lucaricciatl/hand-virtualization/Relazione SGN - VR hand/copertina.tex

%Copertina

\title{Progetto del corso di Sistemi di Guida e Navigazione}
\author{
  Ilaria Martelli\\
}
\date{\today}

\begin{figure}[htp]
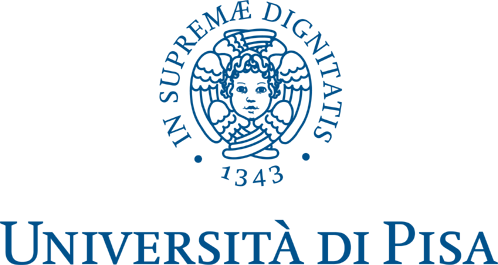
[picture p42: Relazione SGN - VR hand/immagini/unipi.png]

\centering
\end{figure}

\begin{center}
\sc\centering\onehalfspacing\fontsize{4mm}{6mm}\selectfont Dipartimento di Ingegneria Dell'Informazione\\Corso di Ingegneria Robotica e dell'Automazione\\
\end{center}
\begin{center}
\vspace{2cm}

\Huge\bfseries\sc Sistemi di Guida e Navigazione\\[1cm] \bfseries\Large\sc Relazione:\\ AHRS sensor-based\\ Motion Tracking Glove %[0.3cm]\normalsize\sc Subtitle\\ 
\end{center}
\vspace{2cm}

\begin{center}
Ilaria Martelli\\
Luca Ricci\\
\vspace{0.5cm}
\today
\end{center}
\clearpage
