lucaricciatl/hand-virtualization/Relazione SGN - VR hand/7-Conclusioni.tex

\section{Conclusioni}

Nella simulazione le dita sono state piegate a pugno cosi da poter visualizzare adeguatamente la posizione del dito.\\

Sono stati fatti dei test filmando la mano e la relativa animazione e catturandone dei frame in contemporanea cosi da poterle mettere a confronto.\\

Come possiamo vedere dalle figure la posizione della mano virtuale rispecchia quella della mano reale e anche la posizione del dito virtuale rispecchia adeguatamente quella del dito reale per ogni posizione della mano.\\\\

\clearpage
