lucaricciatl/hand-virtualization/Relazione SGN - VR hand/immagini/distorsione campo magnetico.PNG

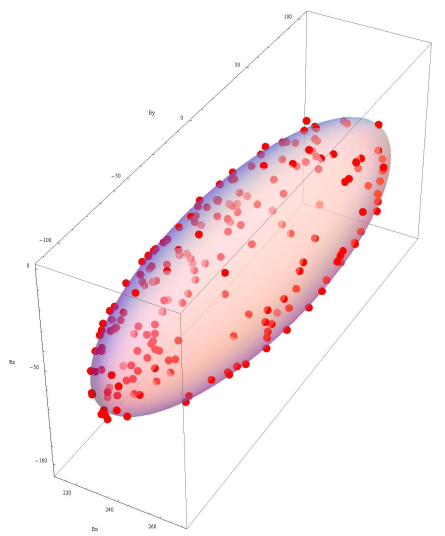
Relazione SGN - VR hand/immagini/distorsione campo magnetico.PNG
