lucaricciatl/hand-virtualization/Relazione SGN - VR hand/immagini/giroscopio integrazione.png

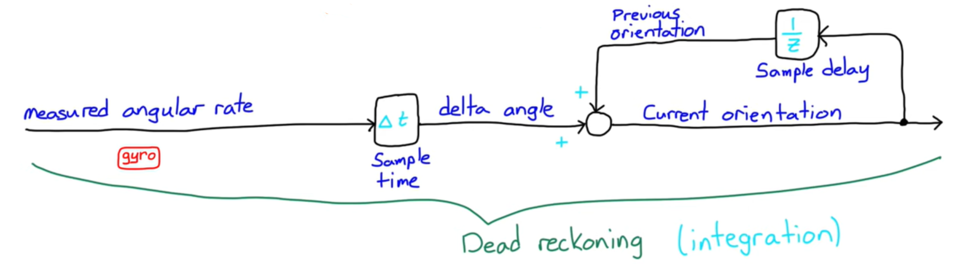
Relazione SGN - VR hand/immagini/giroscopio integrazione.png
