lucaricciatl/hand-virtualization/Relazione SGN - VR hand/immagini/IMU_sdr_gyro.jpg

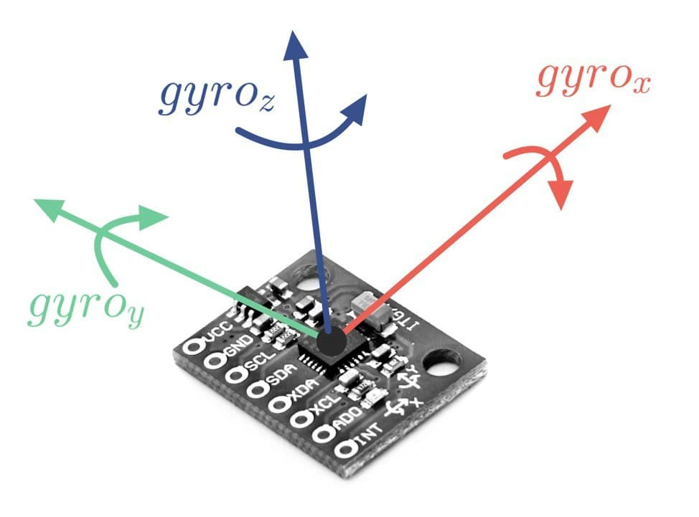
Relazione SGN - VR hand/immagini/IMU_sdr_gyro.jpg
