lucaricciatl/hand-virtualization/Relazione SGN - VR hand/immagini/phalanges.png

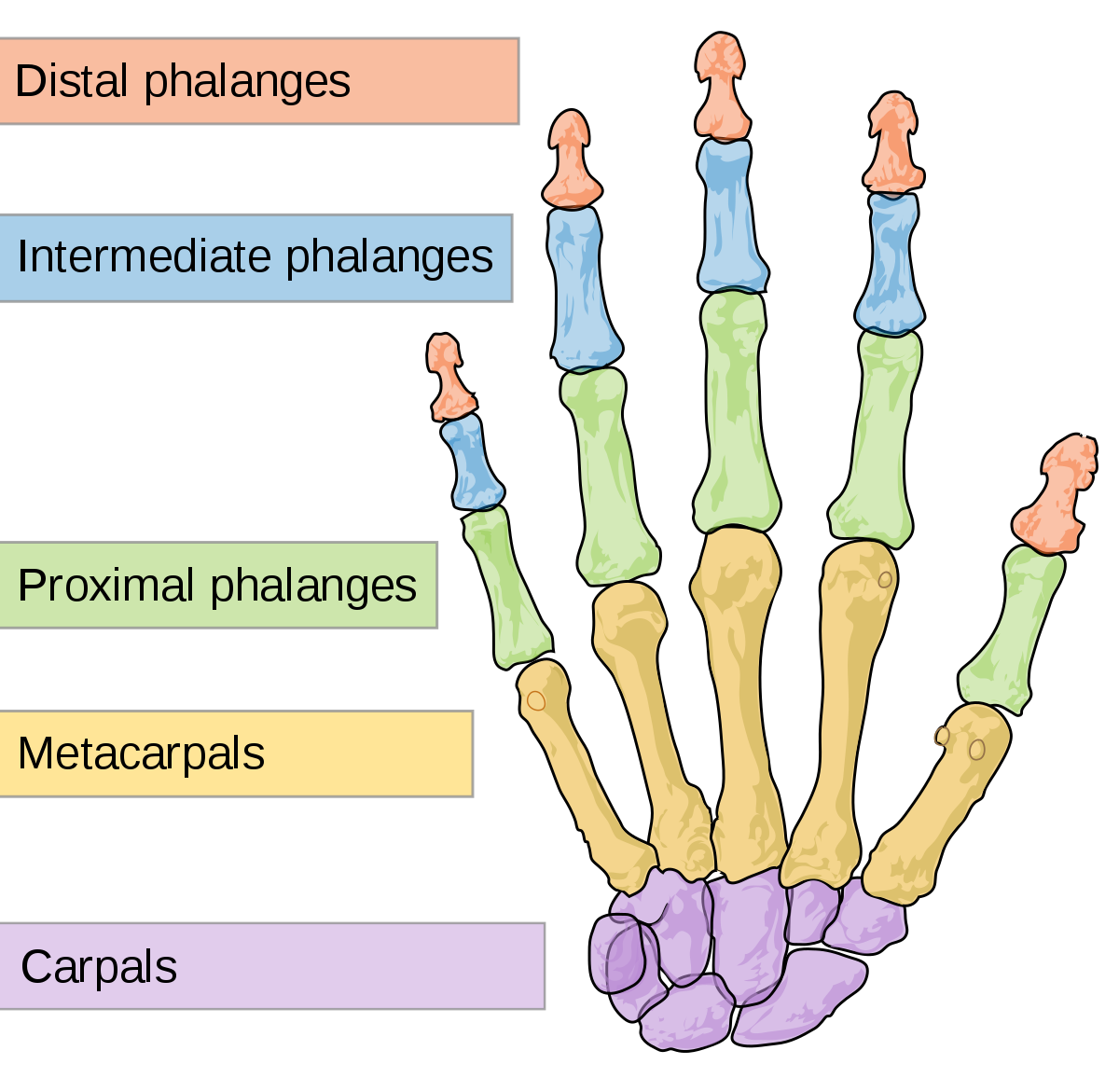
Relazione SGN - VR hand/immagini/phalanges.png
