lucaricciatl/hand-virtualization/dev_ws/src/DataElaborationAndFiltering/DataElaborationAndFiltering/FilterProgram/constants.py

#!/usr/bin/env python
# encoding: utf-8
"""
constants.py
"""
import numpy as np 

PI = 3.141592653589793
RAD_TO_DEG = 180/PI
DEG_TO_RAD = PI/180

MPURAWDATA_0 = [.0,.0,.0,.0,.0,.0,.0,.0,.0 ]
MPURAWDATA_1 = [.0,.0,.0,.0,.0,.0,.0,.0,.0 ]
MPURAWDATA_2 = [.0,.0,.0,.0,.0,.0,.0,.0,.0 ]
MPURAWDATA_3 = [.0,.0,.0,.0,.0,.0,.0,.0,.0 ]
MPURAWDATA_4 = [.0,.0,.0,.0,.0,.0,.0,.0,.0 ]
MPURAWDATA_5 = [.0,.0,.0,.0,.0,.0,.0,.0,.0 ]
MPURAWDATA_6 = [.0,.0,.0,.0,.0,.0,.0,.0,.0 ]
MPURAWDATA_7 = [.0,.0,.0,.0,.0,.0,.0,.0,.0 ]
MPURAWDATA_8 = [.0,.0,.0,.0,.0,.0,.0,.0,.0 ]
MPURAWDATA_9 = [.0,.0,.0,.0,.0,.0,.0,.0,.0 ]
MPURAWDATA_10 = [.0,.0,.0,.0,.0,.0,.0,.0,.0 ]
MPURAWDATA_11 = [.0,.0,.0,.0,.0,.0,.0,.0,.0 ]
MPURAWDATA_12 = [.0,.0,.0,.0,.0,.0,.0,.0,.0 ]

ALPHA_0 = 0.98
ALPHA_1 = 0.98
ALPHA_2 = 0.98

MPUSDR_0 = np.zeros(3)
MPUSDR_1 = np.zeros(3)
MPUSDR_2 = np.zeros(3)
MPUSDR_3 = np.zeros(3)
MPUSDR_4 = np.zeros(3)
MPUSDR_5 = np.zeros(3)
MPUSDR_6 = np.zeros(3)
MPUSDR_7 = np.zeros(3)
MPUSDR_8 = np.zeros(3)
MPUSDR_9 = np.zeros(3)
MPUSDR_10 = np.zeros(3)
MPUSDR_11 = np.zeros(3)
MPUSDR_12 = np.zeros(3)

QUAT_MPU_0 = np.array([1.0,.0,.0,.0])
QUAT_MPU_1 = np.array([1.0,.0,.0,.0])
QUAT_MPU_2 = np.array([1.0,.0,.0,.0])
QUAT_MPU_3 = np.array([1.0,.0,.0,.0])
QUAT_MPU_4 = np.array([1.0,.0,.0,.0])
QUAT_MPU_5 = np.array([1.0,.0,.0,.0])
QUAT_MPU_6 = np.array([1.0,.0,.0,.0])
QUAT_MPU_7 = np.array([1.0,.0,.0,.0])
QUAT_MPU_8 = np.array([1.0,.0,.0,.0])
QUAT_MPU_9 = np.array([1.0,.0,.0,.0])
QUAT_MPU_10 = np.array([1.0,.0,.0,.0])
QUAT_MPU_11 = np.array([1.0,.0,.0,.0])
QUAT_MPU_12 = np.array([1.0,.0,.0,.0])
